jiyikegu1/STC_Reality_Project/README.md

# STC_Reality_Project
STC系列单片机真实项目集，涉及STC系列单片机、led灯、树脂封装摆台类
