jiyikegu1/STC_Reality_Project/STC15水晶摆台/Doc/PCB/参考资料/BY9301-24QS/BY9301-24QS开发资料/QSSOP24封装尺寸图.png

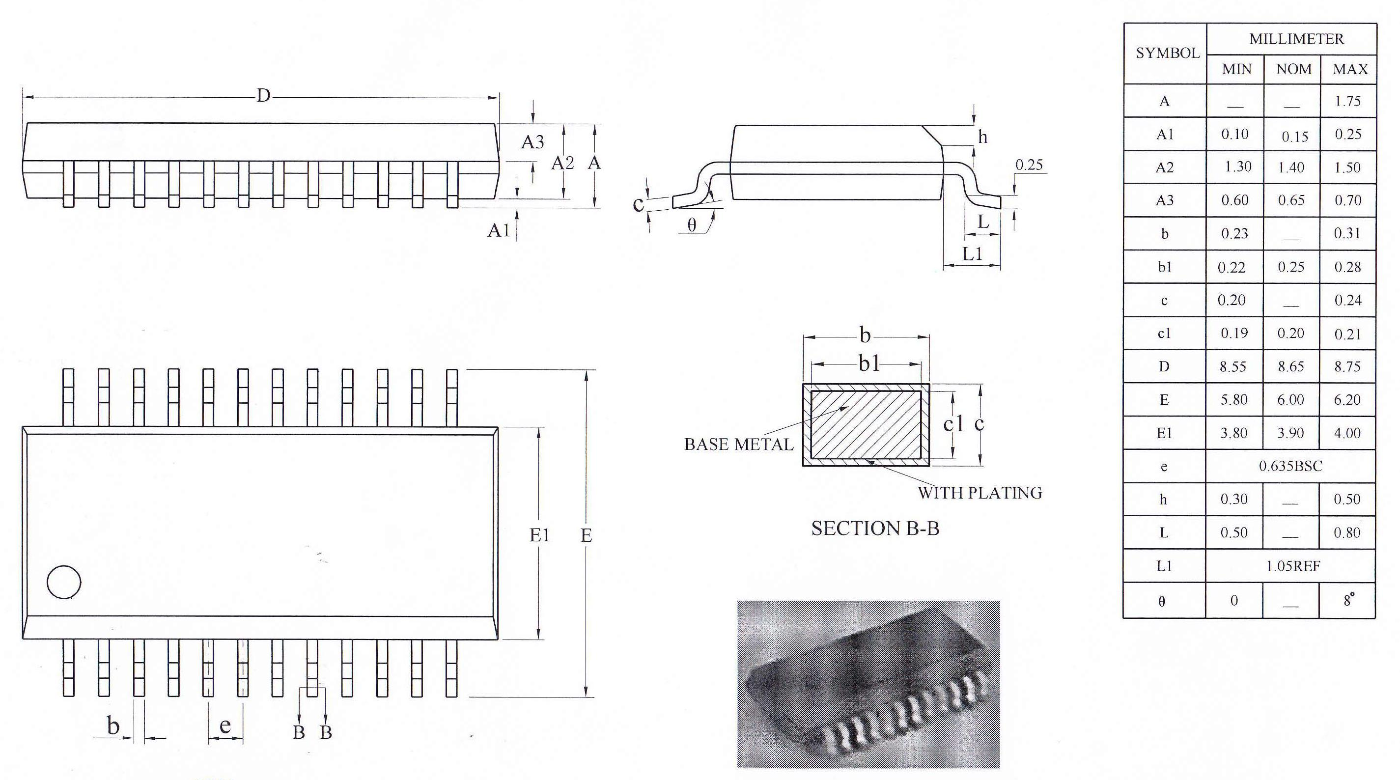
STC15水晶摆台/Doc/PCB/参考资料/BY9301-24QS/BY9301-24QS开发资料/QSSOP24封装尺寸图.png
