jiyikegu1/STC_Reality_Project/STC15水晶摆台/Doc/PCB/版本号/V0.4/STC8H8K64U流水灯.xlsx

STC8H8K64U流水灯_V0.4_2024-1-24
序号 | 名称 | 型号 | 值 | 封装 | 品牌 | 位置 | 数量 | 备注
1 |  |  | 0.1uF | C0603 |  | C4, C5, C11, C20, C21, C22 | 6
2 |  |  | 0.15uF | C0603 |  | C14 | 1
3 |  |  | 1uF | C0603 |  | C9，C10, C12, C13, C18 | 5
4 |  |  | 4.7uF | C0603 |  | C19 | 1
5 |  |  | 10uF | C0603 |  | C3, C15, C16, C17，C25, C26 | 6
6 | 电阻 |  | 0 | R0603 |  | R81, R82 | 2
7 |  |  | 100 | R0603 |  | R80, R87 | 2
8 |  |  | 1k | R0603 |  | R1至R70, R78, R79, R95, R96，R101 | 75
9 |  |  | 1.2k | R0603 |  | R100 | 1
10 |  |  | 3.3k | R0603 |  | R83, R84, R85 | 3
11 |  |  | 4.7k | R0603 |  | R74, R90, R92, R94 | 4
12 |  |  | 10k | R0603 | 1% | R72，R76, R77，R86 | 4
13 |  |  | 39k | R0603 |  | R97 | 1
14 |  |  | 100k | R0603 |  | R75 | 1
15 |  |  | 2M | R0603 |  | R73, R88, R89, R91, R93 | 5
16 | LED指示灯 | TLMG1100-GS08 |  | LED0603 |  | LED1至LED73 | 73
17 | 轻触开关 | 1TS005F-2500-5001 |  | KEY-SMD_4P | 品牌： HYP(鸿源精密) | SW1, SW3, SW4, SW5 | 4
18 |  | CJ2301 S1 |  | SOT-23 | 品牌:CJ(江苏长电/长晶) | Q3 | 1
19 | 语音芯片 | BY9301-24QS |  | QSOP-24 | 品牌：深圳百为 | U11 | 1
20 | 三极管 | S8050 |  | SOT-23 | 品牌:CJ(江苏长电/长晶) | Q2 | 1
21 | 二极管 | BAT42W |  | SOD-123 | 品牌:CJ(江苏长电/长晶) | D2 | 1
22 | NOR FLASH | ZD25Q16BTIGT |  | SOP-8 | 品牌：Zetta(澜智) | U12 | 1
23 | 单片机 | STC8H8K64U-45I- LQFP64 |  | LQFP64S(12x12) | 品牌：STC | U1 | 1 | 官方：2.5元
24 | 红外接收头 | IRM-H638T/TR2 |  | SMD-4P_IRM-H638T/TR2 | 品牌:EVERLIGHT(亿光) | IR1 | 1
25 | 自恢复保险丝 | JK-nSMD075-13.2 |  | F1206 | 品牌： JK(金科) | F1 | 1
26 | 音频功率放大器 | MIX2002 |  | SOP-8 | 品牌：MIXINNO(矽诺微) | U13 | 1
27 | 移位寄存器 | SM74HC595D |  | SOP-16 | 品牌：明微 | U2, U3, U4, U5, U6, U7, U8, U9, U10 | 9
28 | 电池充电芯片 | TC4056A |  | SOP-8-EP | 品牌：FM(富满) | U15 | 1
29 | 焊线 | DSWB01LHGET |  | STM-2P | 品牌：YE | SW2 | 1 | 不买
30 |  | 串口 |  | STM-4P | 2.54*4-Pin | P10 | 1
31 |  |  |  | STM-2P | Header, 2-Pin | P0 | 1
32 |  | battery |  | STM-2P | Header, 2-Pin | P3 | 1
33 |  | 2.54*4-P排针 |  | STM-5P |  | P1 | 1
34 |  | 2.54*4-P排针 |  | STM-4P | 生产不焊接 | P4 | 1
35 |  |  |  | STM-2P | SM对插线母头（大头）P=2.5mm | P2 | 1
