jiyikegu1/STC_Reality_Project/(list of files, cad)

Other CAD files:
STC15水晶摆台/Objects/STC15_main.obj
STC15水晶摆台/Doc/PCB/版本号/STC15水晶摆台.DWG
STC15水晶摆台/Objects/STARTUP.obj
STC15水晶摆台/Objects/delay_ms.obj
STC15水晶摆台/Objects/BY9301_24QS.obj
STC15水晶摆台/Objects/key.obj
STC15水晶摆台/Objects/74HC595D.obj
STC15水晶摆台/Objects/led.obj
STC15水晶摆台/Objects/uart.obj
STC15水晶摆台/Doc/PCB/版本号/V0.3/STC12C5A60S2_led流水灯.DWG
