jiyikegu1/STC_Reality_Project/STC15水晶摆台/Doc/PCB/版本号/V0.4/STC8H8K64U流水灯.pdf

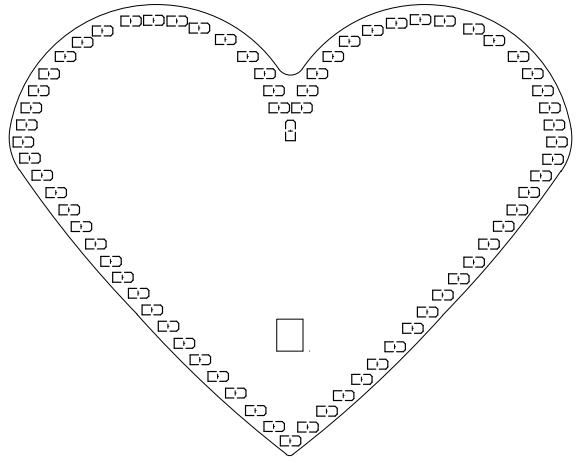
[picture p3: figure]
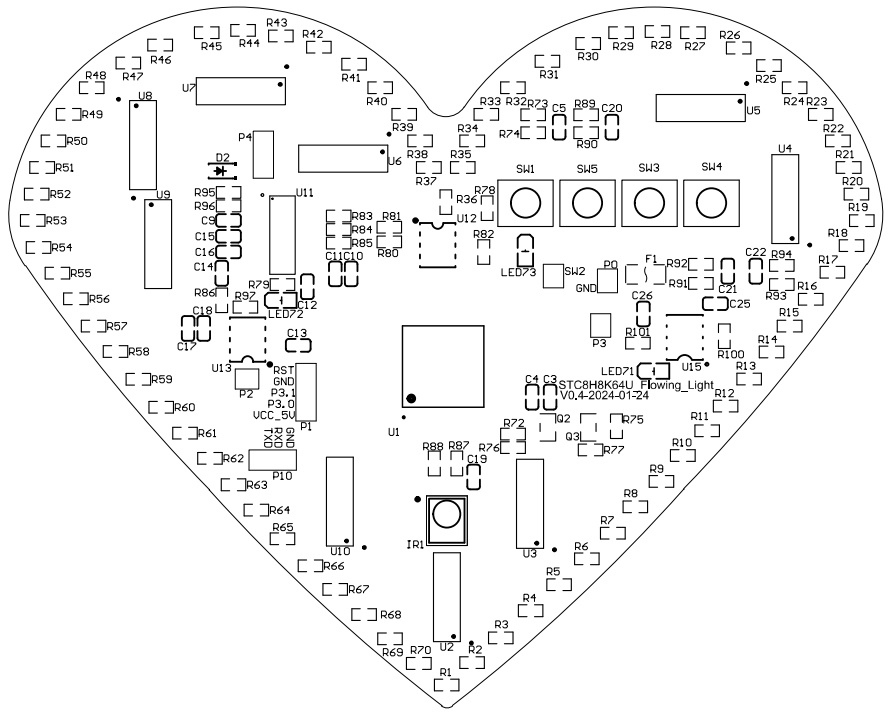
[picture p4: page 2]
