jiyikegu1/STC_Reality_Project/STC15水晶摆台/Doc/PCB/版本号/V0.1/STC12C5-LED-Heart-shaped lamp-原理图.pdf

# USB供电电路DC5V ♥字电路

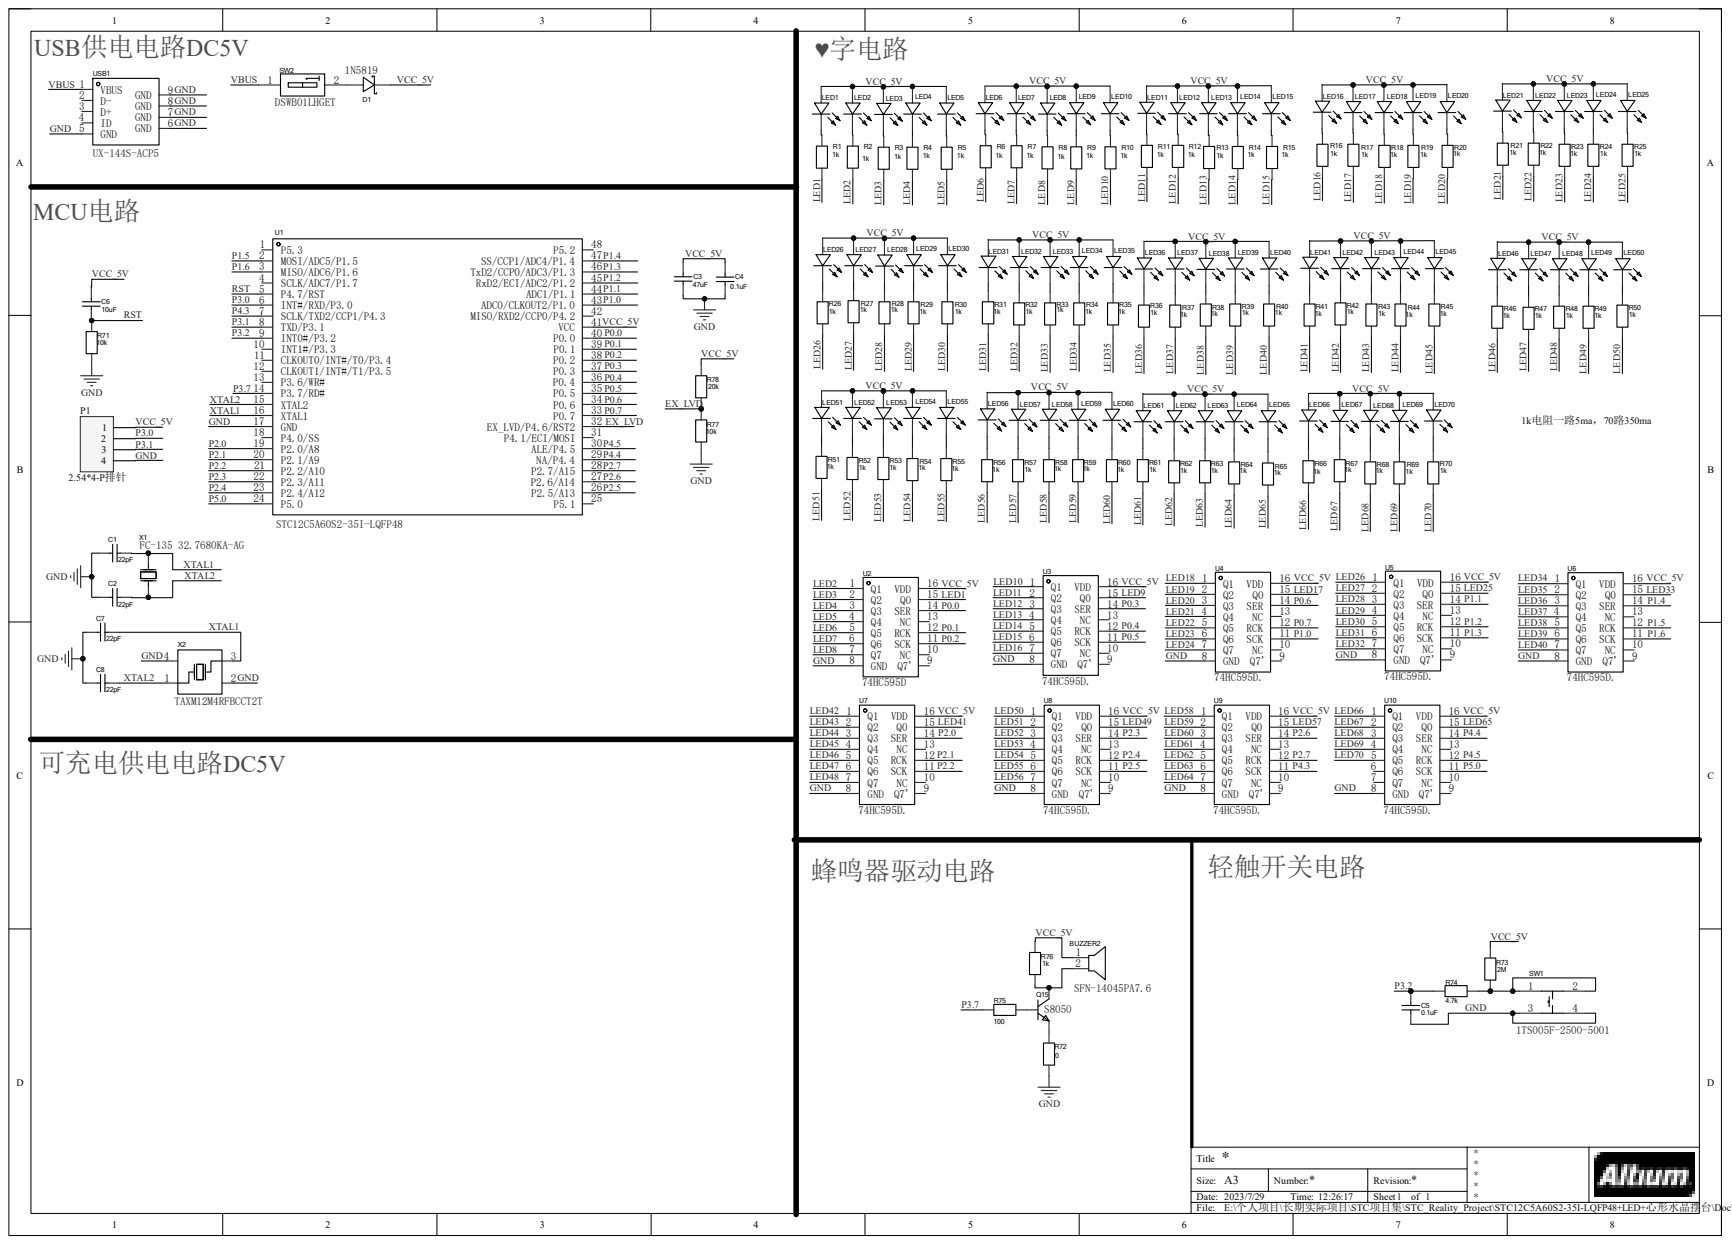
[picture p5: page 1]

Size: A3 Number: * | Revision: *

Date:
E:\个人项目\长期实际项目\STC项目集\STC_Reality_Project\STC12C5A60S2-35I-LQFP48+LED+心形水晶摆台\Doc\
File:
