jiyikegu1/STC_Reality_Project/STC15水晶摆台/Doc/PCB/版本号/V0.3/STC12C5A60S2_led流水灯.pdf

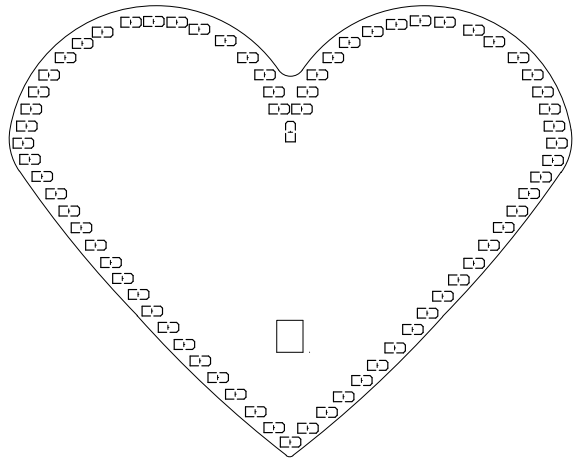
[picture p6: figure]
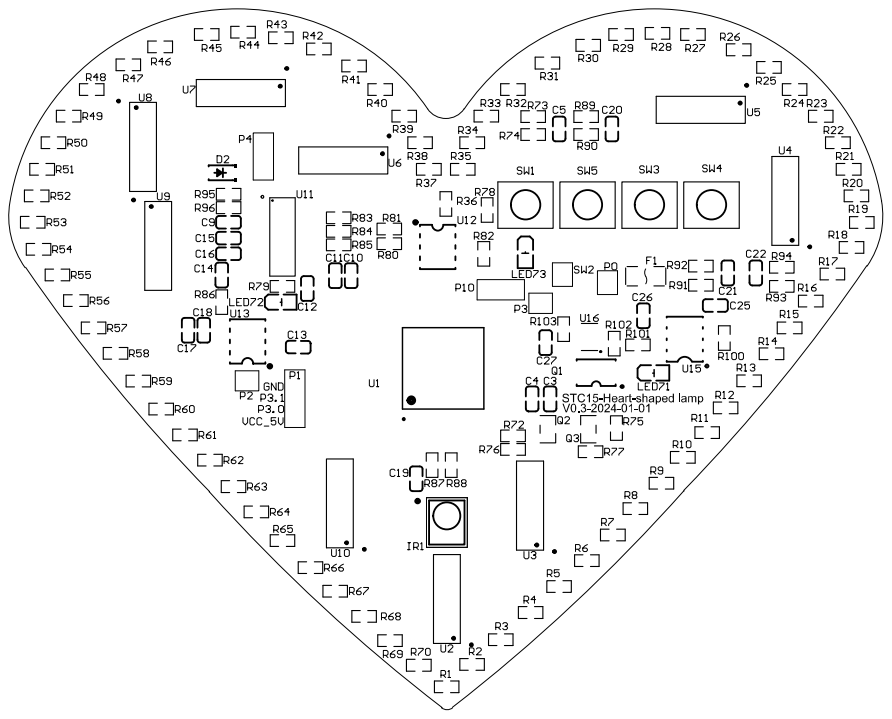
[picture p7: page 2]
