jiyikegu1/STC_Reality_Project/STC15水晶摆台/Doc/PCB/版本号/V0.2/STC12C5A60S2-35I-LQFP48_led流水灯_Project.pdf

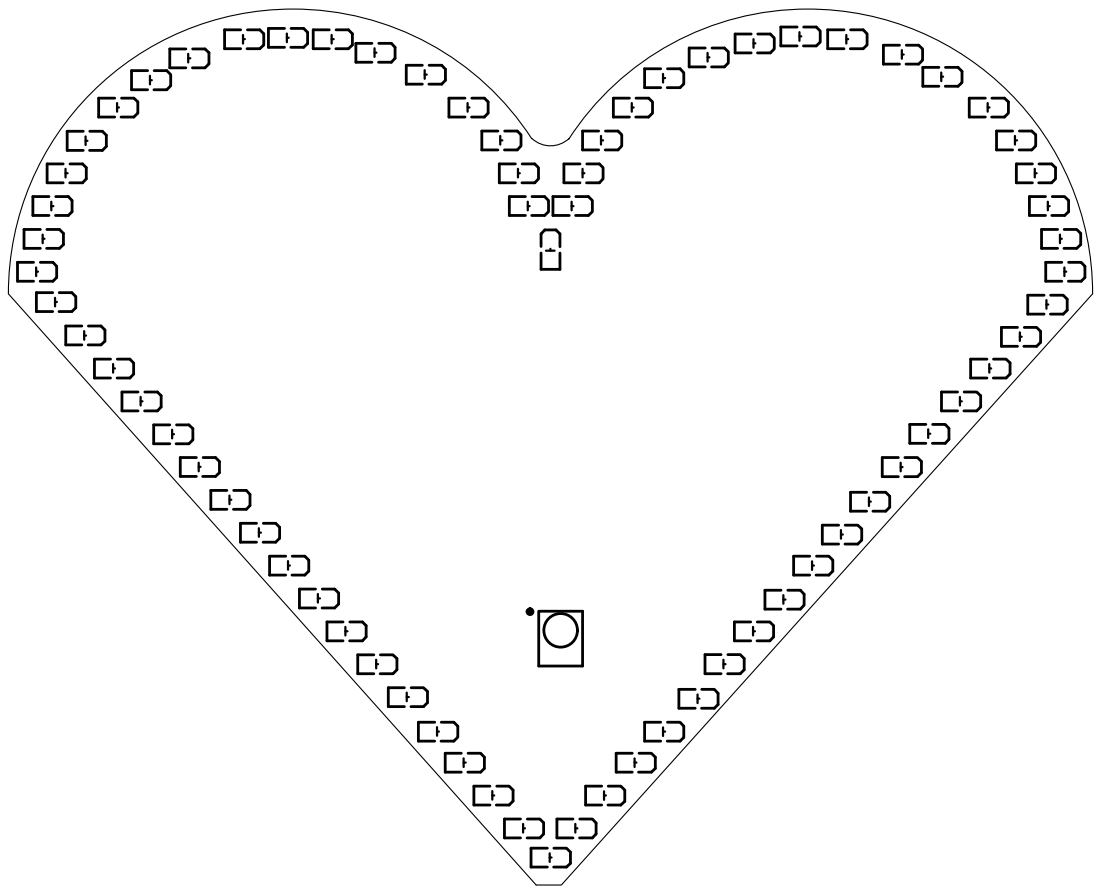
[picture p8: page 1]

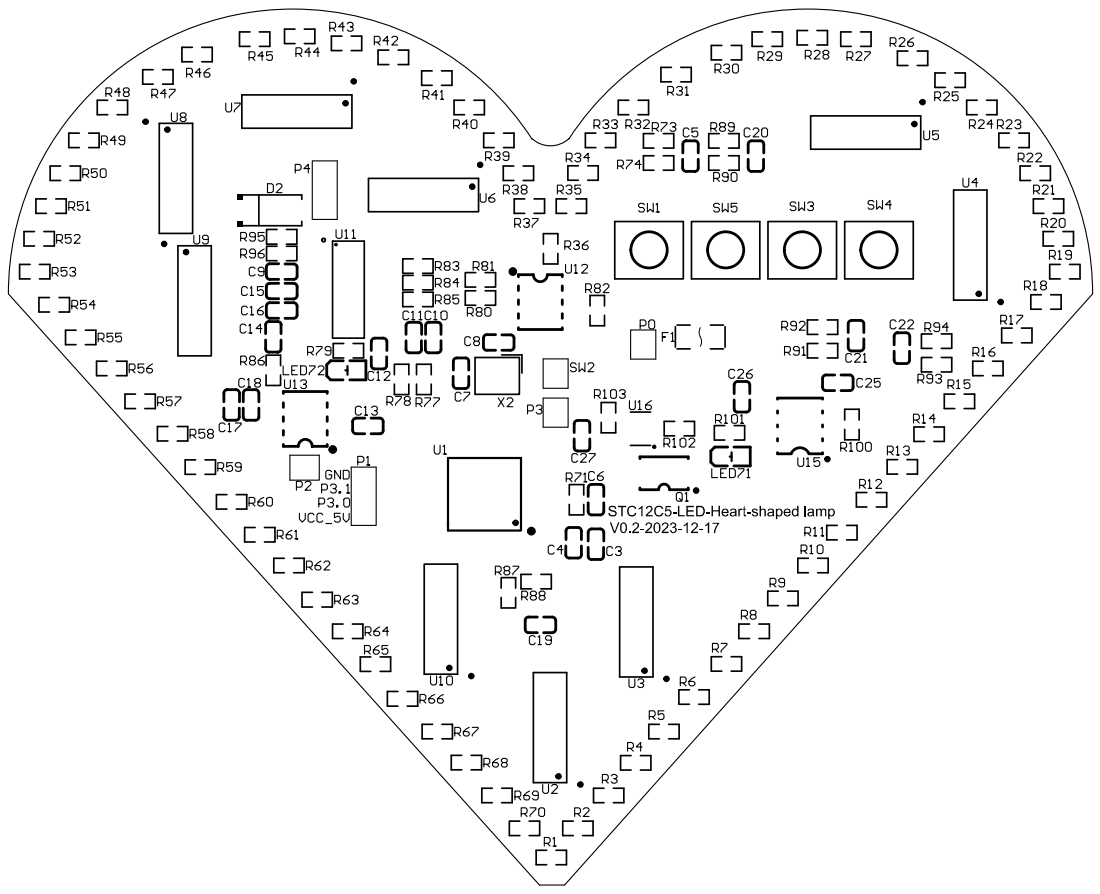
[picture p9: page 2]
