jiyikegu1/STC_Reality_Project/STC15水晶摆台/Doc/PCB/版本号/V0.1/STC12C5-LED-Heart-shaped lamp-丝印.pdf

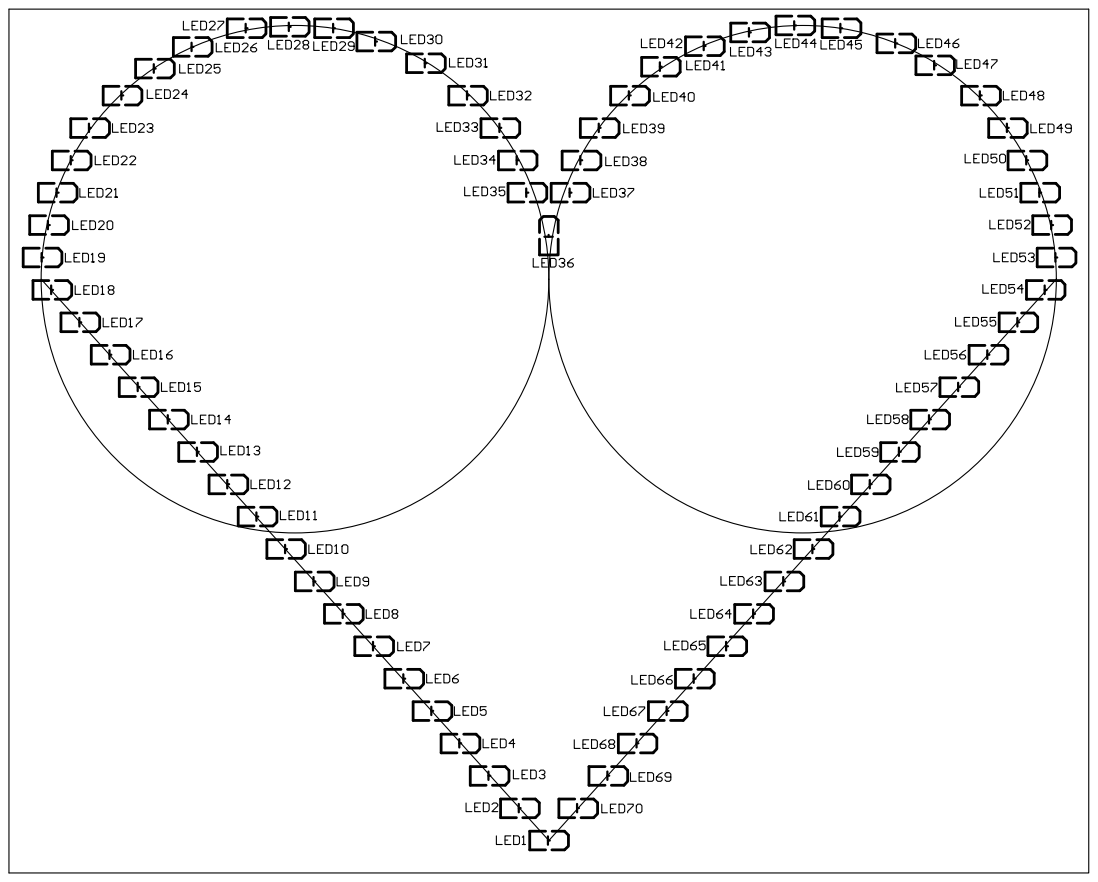
[picture p10: page 1]

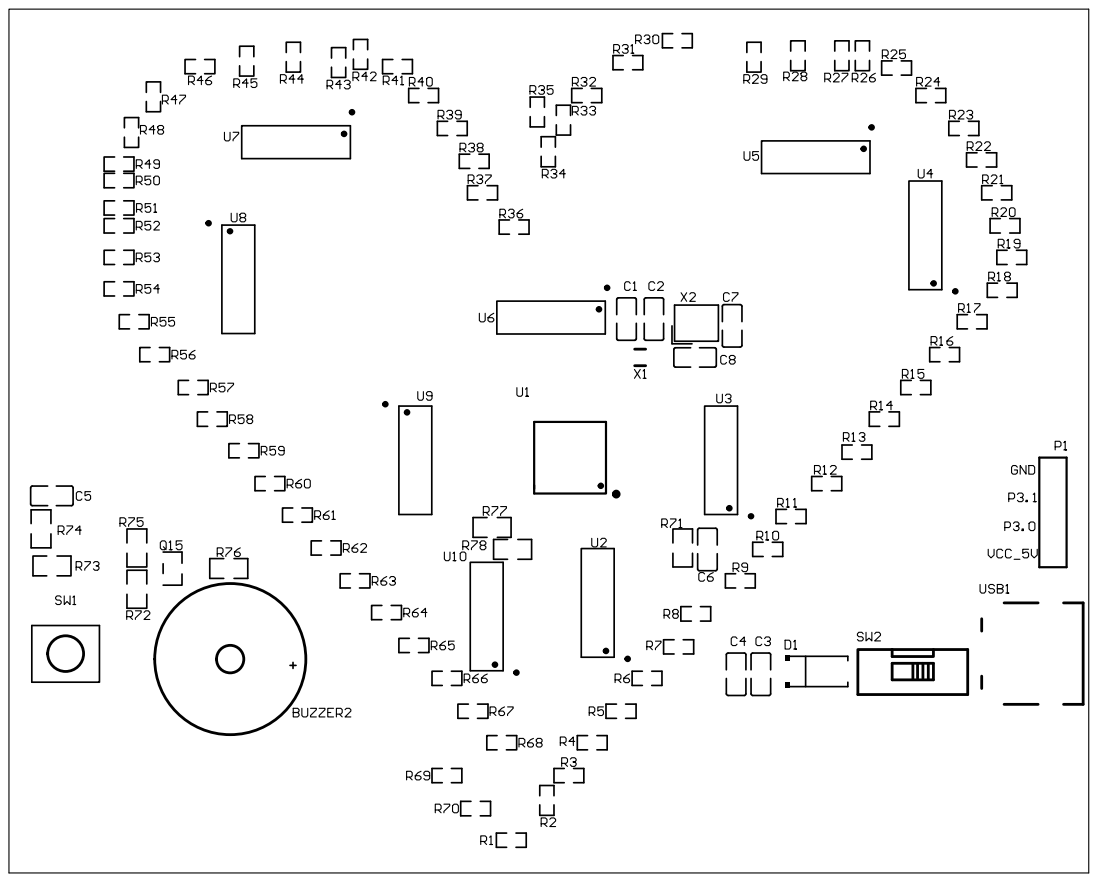
[picture p11: page 2]
