jiyikegu1/STC_Reality_Project/(list of files, drawings)

Other design files:
STC15水晶摆台/Doc/PCB/STC8H8K64U流水灯.PrjPcb
STC15水晶摆台/Doc/PCB/STC8H8K64U流水灯.SchDoc
STC15水晶摆台/Doc/PCB/参考资料/BY9301-24QS/BY9301-24QS开发资料/QSOP24封装_PADS.pcb
STC15水晶摆台/Doc/PCB/参考资料/单片机/LQFP-48_L7.0-W7.0-P0.50-LS9.0-BL.pcbdoc
STC15水晶摆台/Doc/PCB/参考资料/单片机/STC12C5A60S2-35I1_STC12C5A60S2-35I.schdoc
STC15水晶摆台/Doc/PCB/版本号/V0.1/STC89C52_led流水灯_Project.PrjPcb
STC15水晶摆台/Doc/PCB/版本号/V0.1/STC89C52_led流水灯_Project.SchDoc
STC15水晶摆台/Doc/PCB/版本号/V0.3/STC12C5A60S2_led流水灯.PrjPcb
STC15水晶摆台/Doc/PCB/版本号/V0.3/STC12C5A60S2_led流水灯.SchDoc
STC15水晶摆台/Doc/PCB/版本号/V0.4/STC8H8K64U流水灯.PrjPcb
STC15水晶摆台/Doc/PCB/版本号/V0.4/STC8H8K64U流水灯.SchDoc
