jiyikegu1/STC_Reality_Project/(commit log)

2023-07-28 7-28更新文件
2023-07-28 7-28更新
    [LQFP-48_L7.0-W7.0-P0.50-LS9.0-BL.pcbdoc, STC12C5A60S2-35I-LQFP48_led流水灯_Project.PrjPcb, STC12C5A60S2-35I-LQFP48_led流水灯_Project.SchDoc, STC12C5A60S2-35I1_STC12C5A60S2-35I.schdoc, STC89C52_led流水灯_Project.PrjPcb, STC89C52_led流水灯_Project.SchDoc, STC89C52_led流水灯_Project.xlsx, zhao_PcbLib.PcbLib]
2023-08-13 8-13日志
    [74HC595D.obj, STARTUP.obj, main.obj]
2023-09-05 9-5日志
    [74HC595D.obj, STARTUP.obj, beep.obj, delay_ms.obj, main.obj]
2023-12-18 12-18更新文件
    [74HC595D.obj, QSOP24封装_PADS.pcb, STARTUP.obj, STC12C5A60S2-35I-LQFP48_led流水灯_Project.PrjPcb, STC12C5A60S2-35I-LQFP48_led流水灯_Project.SchDoc, STC12C5A60S2-35I-LQFP48_led流水灯_Project.xlsx, STC12C5A60S2_led流水灯.PrjPcb, STC12C5A60S2_led流水灯.SchDoc]
2024-01-05 1-5日志
    [74HC595D.obj, STARTUP.obj, STC12C5A60S2-35I-LQFP48_led流水灯_Project.xlsx, STC12C5A60S2_led流水灯.DWG, STC12C5A60S2_led流水灯.PrjPcb, STC12C5A60S2_led流水灯.SchDoc, STC12C5A60S2_led流水灯.xlsx, beep.obj]
